hdroncon/autonomous_vehicle/board.jpg

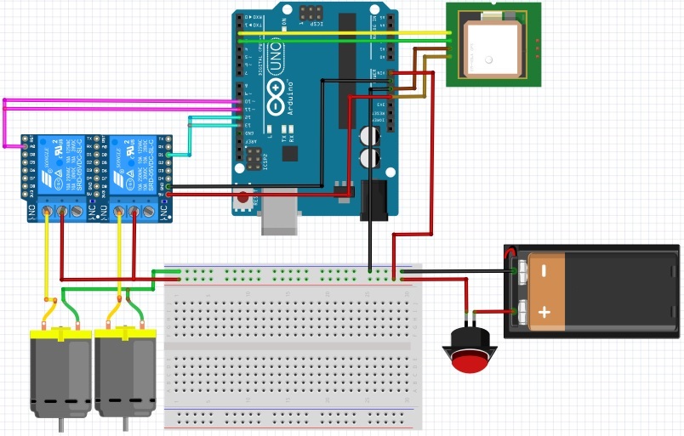
board.jpg
