hdroncon/autonomous_vehicle/Solid/battery.SLDASM

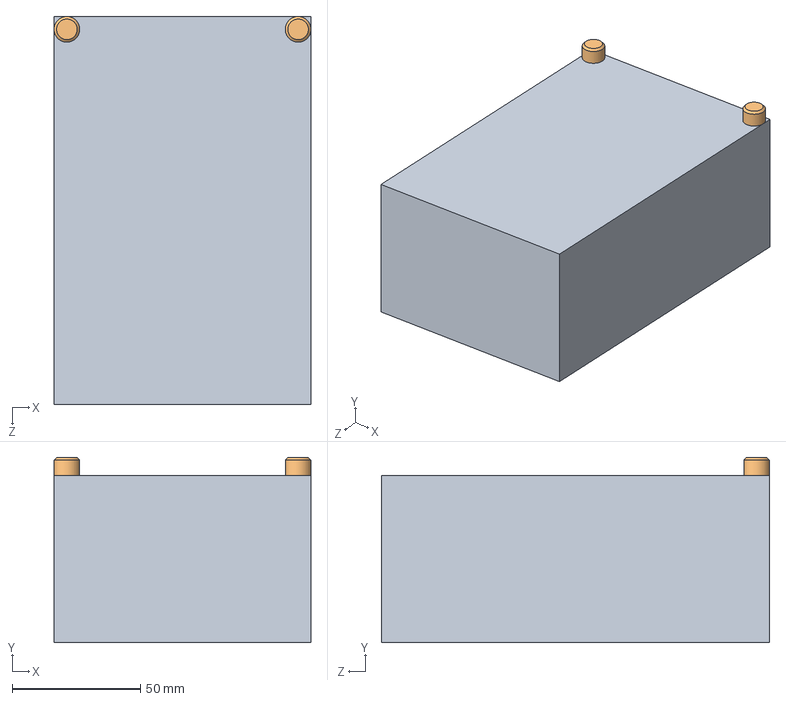
[picture p31: CAD file, 2018-07-21]
Solid/battery.SLDASM
100.0 x 72.0 x 151.0 mm
battery_body
shaft_short x 2
