hdroncon/autonomous_vehicle/Solid/motor.SLDASM

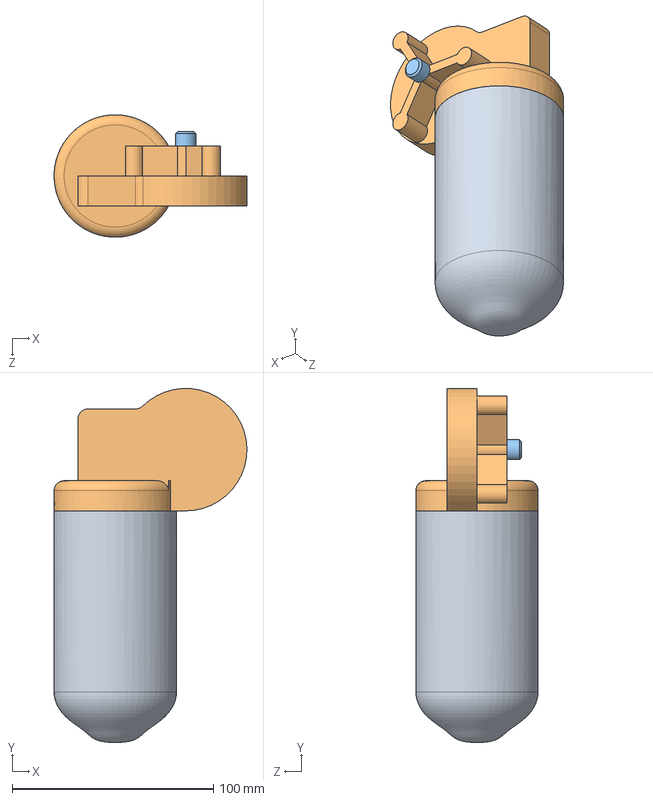
[picture p32: CAD file, 2018-07-21]
Solid/motor.SLDASM
95.8 x 175.8 x 60.8 mm
motor_inf
motor_sup
shaft_short
