hdroncon/autonomous_vehicle/Solid/front_wheel_asm.SLDASM

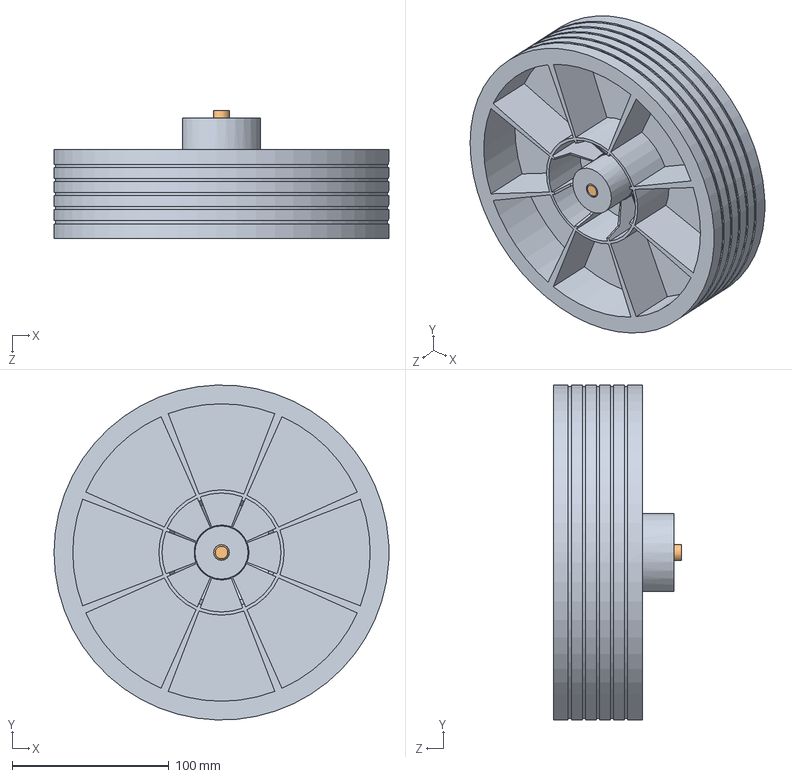
[picture p33: CAD file, 2018-07-21]
Solid/front_wheel_asm.SLDASM
214.0 x 213.9 x 82.0 mm
front_wheel
shaft_long
