hdroncon/autonomous_vehicle/Solid/car.SLDASM

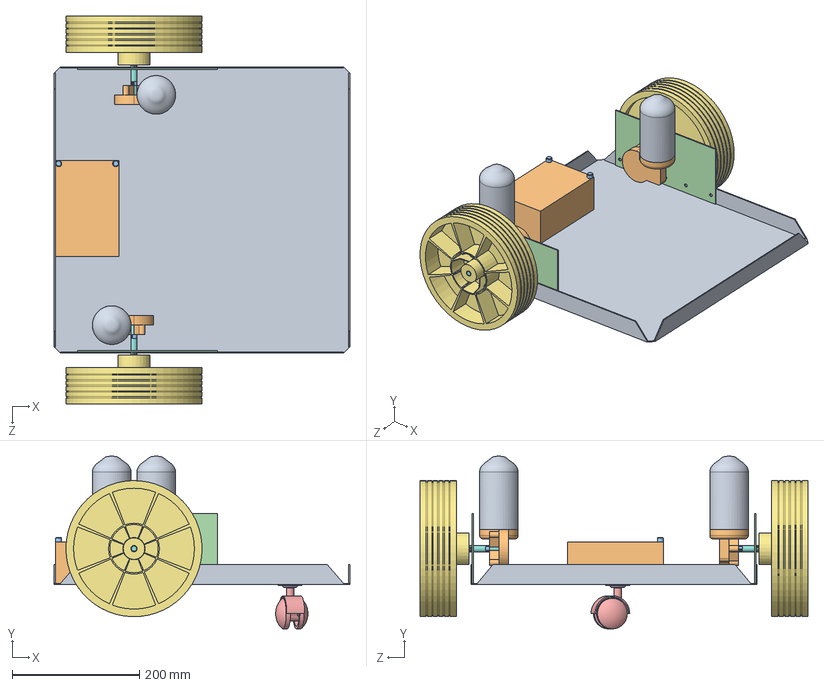
[picture p34: CAD file, 2018-07-21]
Solid/car.SLDASM
465.0 x 271.5 x 610.0 mm
battery_body
shaft_short x 4
front_sheet x 2
rear_wheel
rear_wheel_sup
front_wheel x 2
shaft_long x 4
motor_inf x 2
motor_sup x 2
