hdroncon/autonomous_vehicle/Solid/rear_wheel_asm.SLDASM

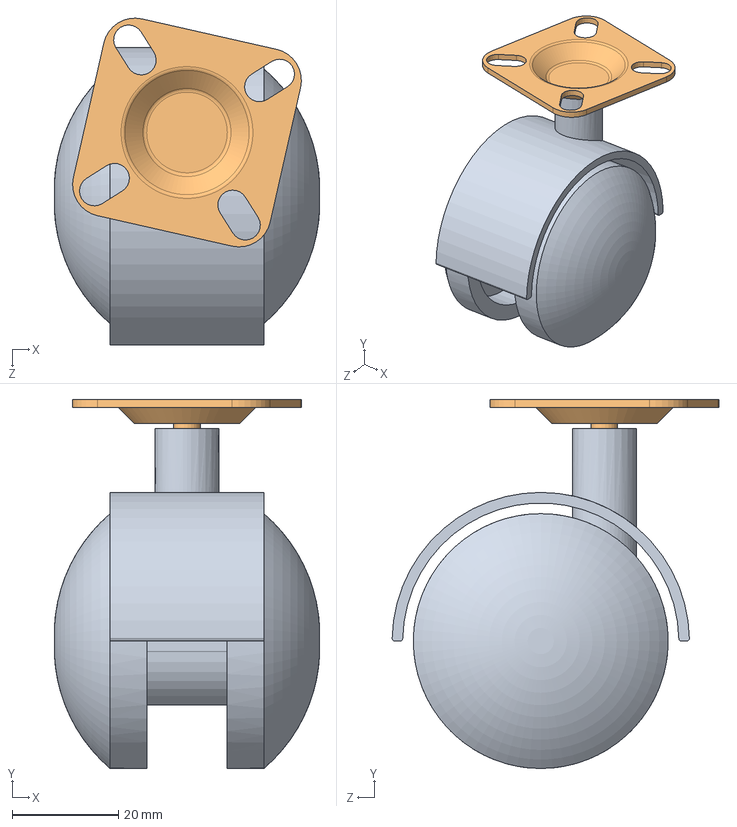
[picture p35: CAD file, 2018-07-21]
Solid/rear_wheel_asm.SLDASM
50.0 x 69.5 x 61.5 mm
rear_wheel
rear_wheel_sup
