hdroncon/autonomous_vehicle/Solid/bushing_shafts.SLDPRT

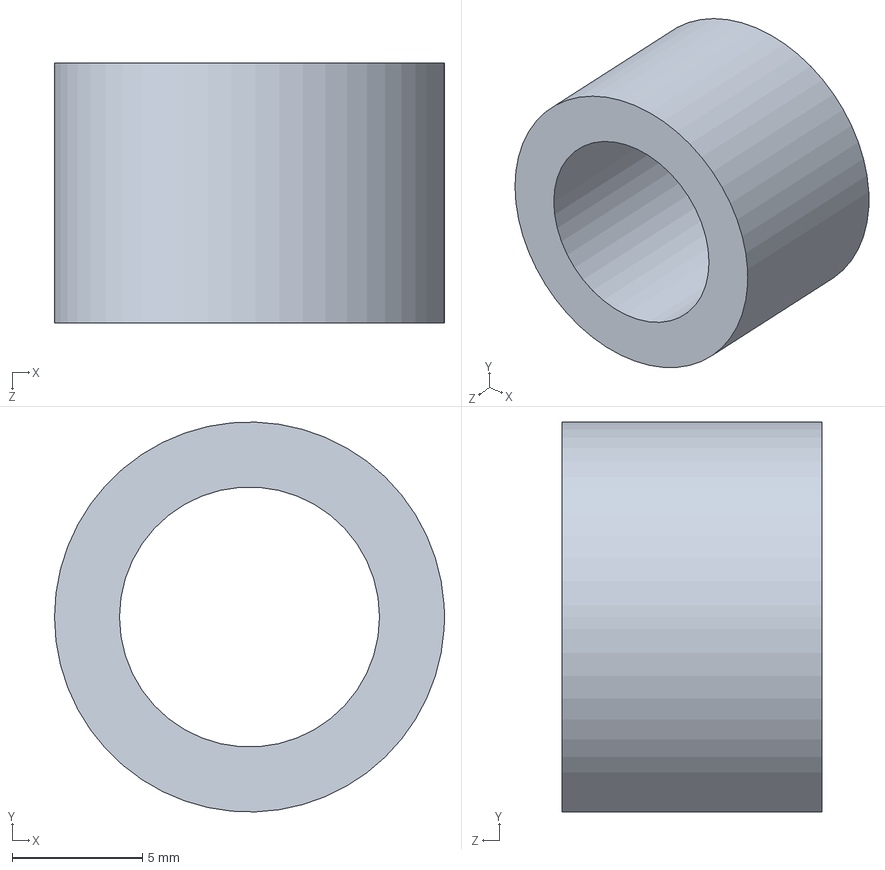
[picture p36: CAD file, 2018-07-21]
Solid/bushing_shafts.SLDPRT
15.0 x 15.0 x 10.0 mm
