hdroncon/autonomous_vehicle/Solid/body.SLDPRT

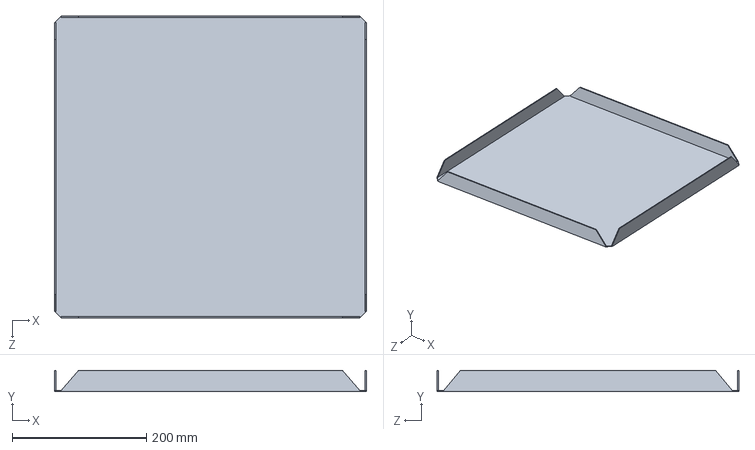
[picture p37: CAD file, 2018-07-21]
Solid/body.SLDPRT
465.0 x 32.0 x 450.0 mm
