hdroncon/autonomous_vehicle/Solid/rear_wheel.SLDPRT

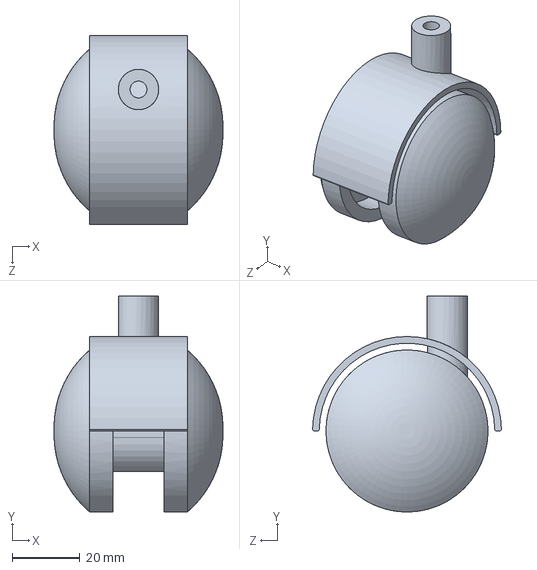
[picture p38: CAD file, 2018-07-21]
Solid/rear_wheel.SLDPRT
50.0 x 64.0 x 56.0 mm
