hdroncon/autonomous_vehicle/Solid/shaft_long.SLDPRT

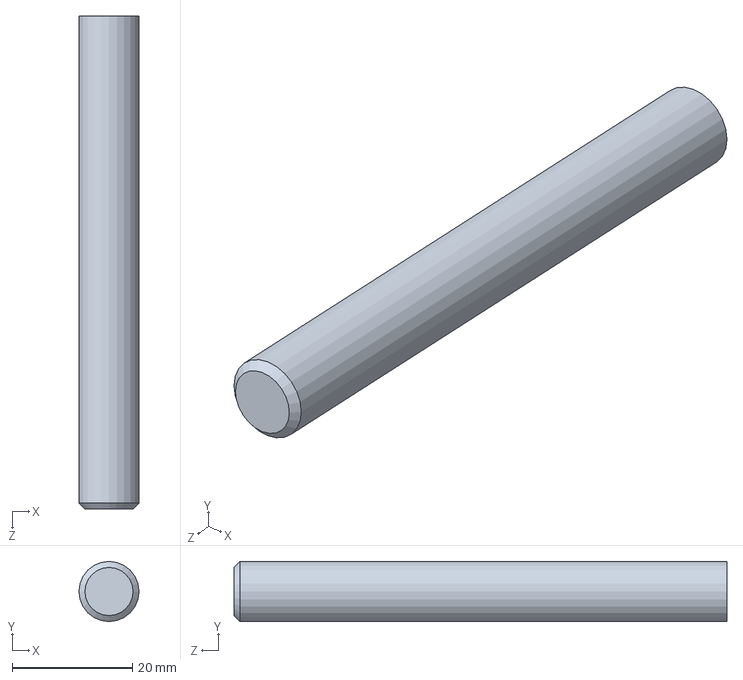
[picture p39: CAD file, 2018-07-21]
Solid/shaft_long.SLDPRT
10.0 x 10.0 x 82.0 mm
