hdroncon/autonomous_vehicle/Solid/front_wheel.SLDPRT

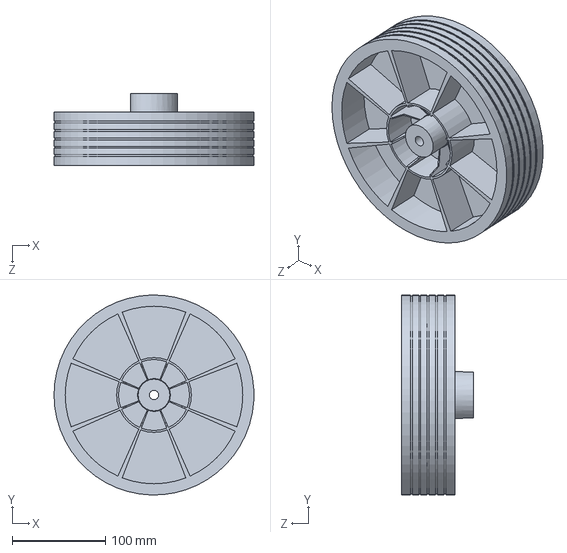
[picture p40: CAD file, 2018-07-21]
Solid/front_wheel.SLDPRT
214.0 x 213.9 x 77.0 mm
