hdroncon/autonomous_vehicle/Solid/front_sheet.SLDPRT

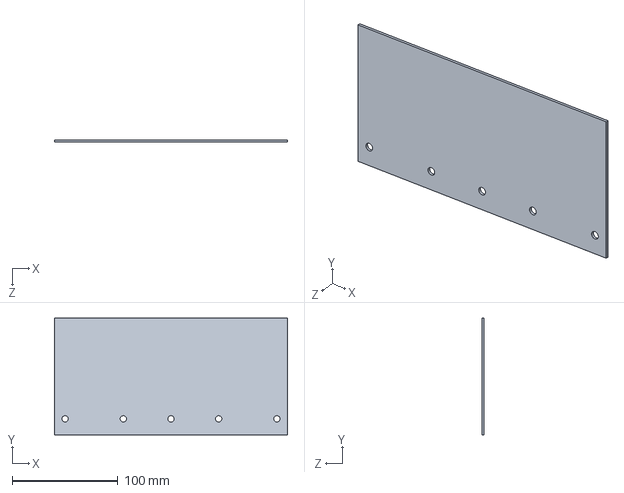
[picture p41: CAD file, 2018-07-21]
Solid/front_sheet.SLDPRT
220.0 x 110.0 x 2.00 mm
