hdroncon/autonomous_vehicle/Solid/motor_sup.SLDPRT

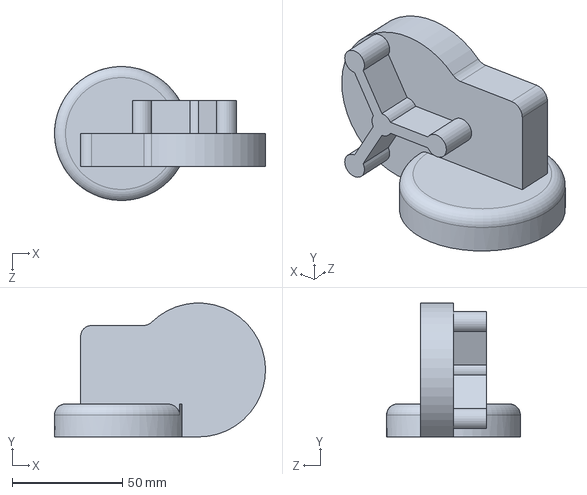
[picture p42: CAD file, 2018-07-21]
Solid/motor_sup.SLDPRT
95.8 x 60.8 x 60.8 mm
