hdroncon/autonomous_vehicle/Solid/motor_inf.SLDPRT

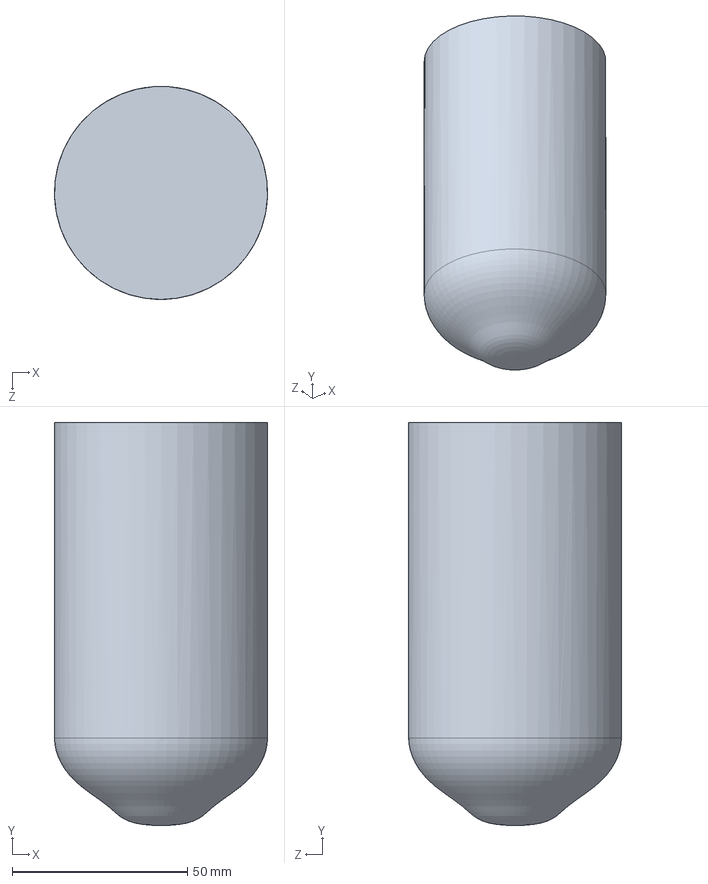
[picture p43: CAD file, 2018-07-21]
Solid/motor_inf.SLDPRT
60.8 x 115.0 x 60.8 mm
