hdroncon/autonomous_vehicle/Solid/shaft_short.SLDPRT

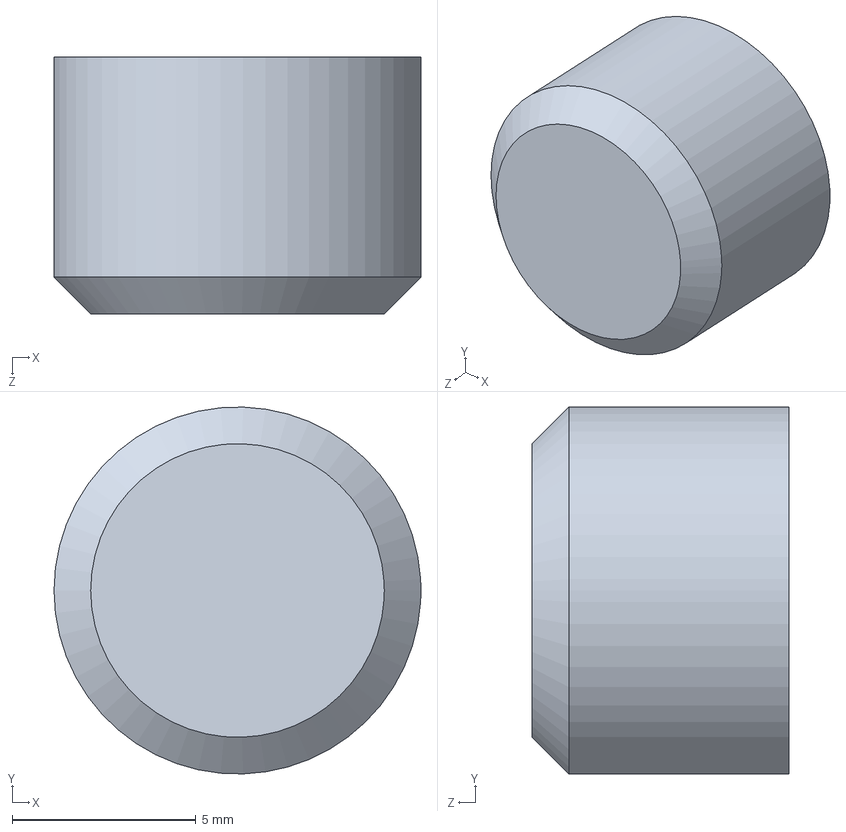
[picture p44: CAD file, 2018-07-21]
Solid/shaft_short.SLDPRT
10.0 x 10.00 x 7.00 mm
