hdroncon/autonomous_vehicle/Solid/battery_body.SLDPRT

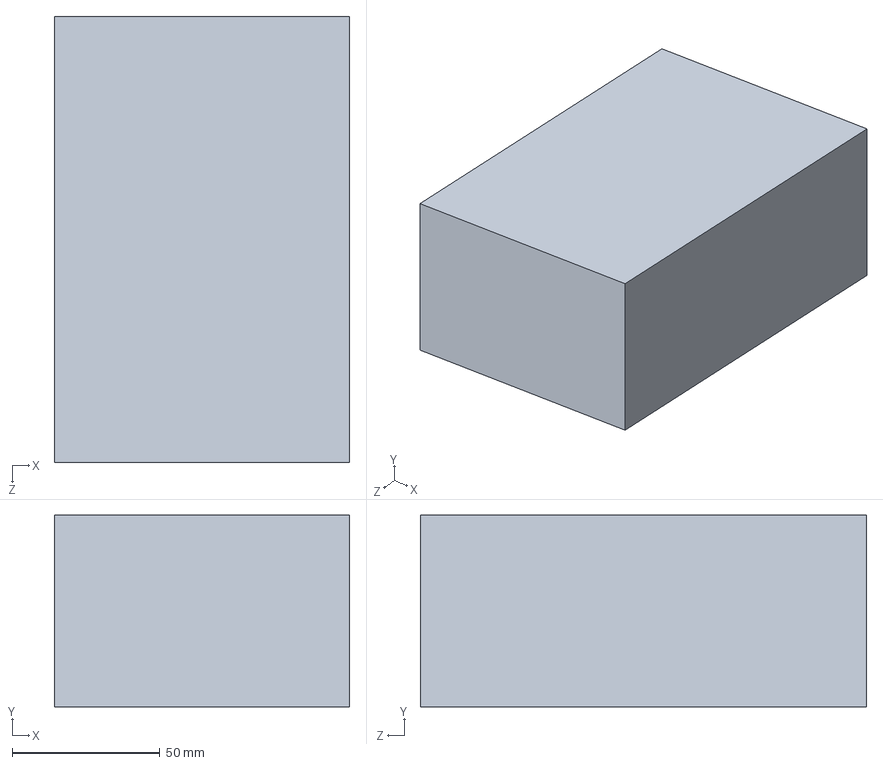
[picture p45: CAD file, 2018-07-21]
Solid/battery_body.SLDPRT
100.0 x 65.0 x 151.0 mm
