hdroncon/autonomous_vehicle/Solid/rear_wheel_sup.SLDPRT

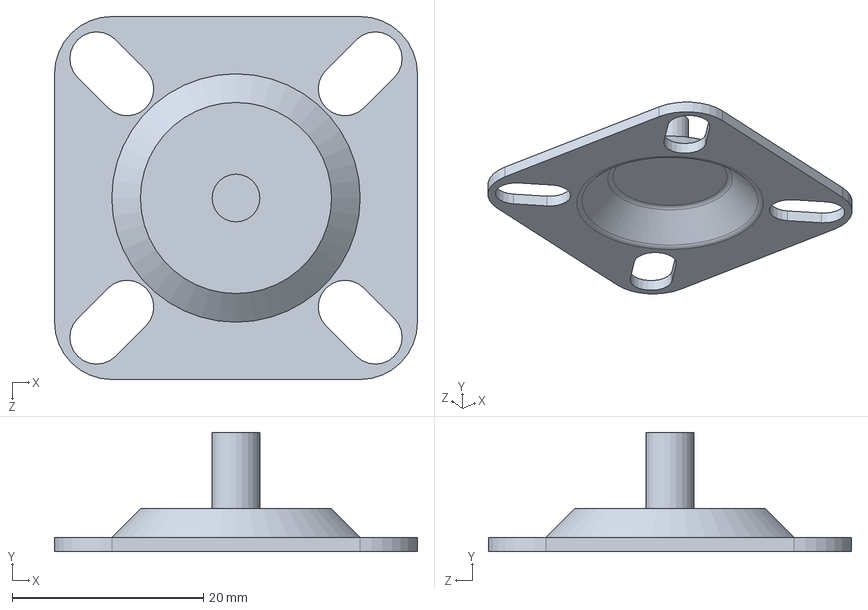
[picture p46: CAD file, 2018-07-21]
Solid/rear_wheel_sup.SLDPRT
38.0 x 12.5 x 38.0 mm
