hdroncon/autonomous_vehicle/(commit log)

2018-07-21 Solidworks parts
    [battery.SLDASM, battery_body.SLDPRT, body.SLDPRT, bushing_shafts.SLDPRT, car.SLDASM, front_sheet.SLDPRT, front_wheel.SLDPRT, front_wheel_asm.SLDASM]
2018-07-21 Wiring (board scheme)
2018-07-21 NMEA lib
    Used to establish connection between Arduino and GPS module.
